kieraneglin/hexagon-art/CAD/cutaway-view.jpg

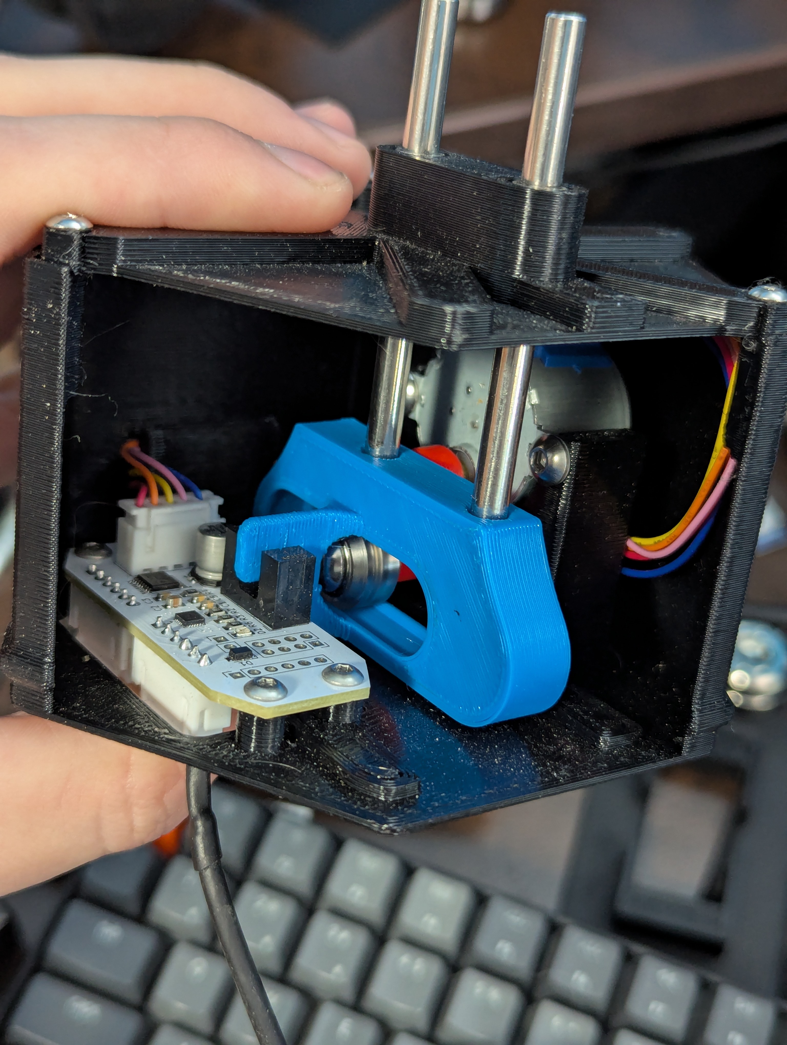
CAD/cutaway-view.jpg
