kieraneglin/hexagon-art/CAD/README.md

# CAD Design for Hexagon Art Piece

## Hardware BOM

### Per-Hexagon Unit

| Part | Quantity | Notes |
| --- | --- | --- |
| M3x10 BHCS | 3 | For attaching lid to body |
| M3x6 BHCS | 2 | For mounting PCB. You can use 4 but there's no need |
| M4x10 BHCS | 2 | For mounting motor |
| M5x16 BHCS | 1 | For mounting POM roller to crank |
| M5x70 Stainless Steel Pins | 2 | [AliExpress](https://www.aliexpress.com/item/1005012213367423.html) |
| M5x7x15 oil-free shaft bushing | 2 | [AliExpress](https://www.aliexpress.com/item/1005004320890614.html) |
| 15.5x8.9 POM wheel | 1 | [AliExpress](https://www.aliexpress.com/item/1005004275676552.html) |
| 28BYJ-48 Stepper Motor | 1 | 12v or 5v - either works. 12v is strongly recommended |
| 6x3 circular magnet | 2 | For attaching the wood piece to the drive pins |
| PCB assembly | 1 | See schematic |
