kieraneglin/hexagon-art/Schematic/hexagon/BOM.csv

Reference | Qty | Value | Footprint | PN
J1,J2,J4,J5,J6,J7,U3 | 7 | ATtiny1616-MN,GPIO Breakout,INPUT BREAKOUT,JST IN,JST OUT,Motor JST,PROGRAMMING BREAKOUT | Connector_JST:JST_XH_B5B-XH-A_1x05_P2.50mm_Vertical,Connector_JST:JST_XH_B6B-XH-A_1x06_P2.50mm_Vertical,Connector_PinHeader_2.54mm:PinHeader_1x02_P2.54mm_Vertical,Connector_PinSocket_2.54mm:PinSocket_1x06_P2.54mm_Vertical,Package_DFN_QFN:VQFN-20-1EP_3x3mm_P0.4mm_EP1.7x1.7mm
D2 | 1 | STATUS LED | LED_SMD:LED_0805_2012Metric_Pad1.15x1.40mm_HandSolder | 5988110107F
C2 | 1 | 10 uF | Capacitor_SMD:C_0805_2012Metric_Pad1.18x1.45mm_HandSolder | C0805C106K8PACTU
C1,C3,C5 | 3 | 100 nF | Capacitor_SMD:C_0805_2012Metric_Pad1.18x1.45mm_HandSolder | CL21B104KACNNNC
PI1 | 1 | LTH-301-07 | OptoDevice:LiteOn_LTH-301-07 | LTH-301-07
D1 | 1 | D_Schottky | Diode_SMD:Nexperia_CFP3_SOD-123W | PMEG2010ER,115
R4 | 1 | 4.7k | Resistor_SMD:R_0805_2012Metric_Pad1.20x1.40mm_HandSolder | RC0805FR-074K7L
R2,R3,R6 | 3 | 220 | Resistor_SMD:R_0805_2012Metric_Pad1.20x1.40mm_HandSolder | RC0805FR-07220RL
U2 | 1 | TPL7407 | Package_SO:TSSOP-16_4.4x5mm_P0.65mm | TPL7407LAQPWRQ1
C4 | 1 | 220 uF | Capacitor_SMD:CP_Elec_6.3x7.7 | UCM1E221MCL1GS
