kieraneglin/hexagon-art/CAD/Hexagon Art.step

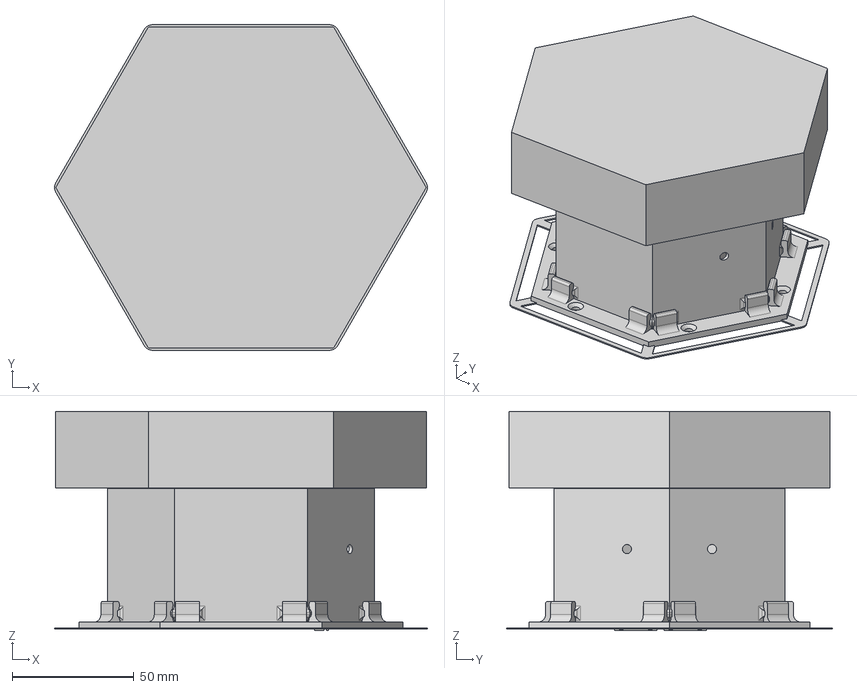
[picture p2: CAD file, 2026-09-25]
CAD/Hexagon Art.step
153.4 x 134.0 x 90.2 mm
Lid
Crank
Yoke
Pin
Motor
Bushing
Slider x 2
Wood Hexagon
Wood Mount
PinSocket_2x04_P2.54mm_Vertical_1
FusionComponent
CP_Elec_63x77
JST_B5B_XH_A
R_0805_2012Metric_1 x 4
PinHeader_1x02_P254mm_Vertical
C_0805_2012Metric_1 x 4
LED_0805_2012Metric_1
PinSocket_1x06_P2.54mm_Vertical_1
60816e3e-9268-11ed-8af4-a0cec80452fd_part
6081710e-9268-11ed-8af4-a0cec80452fd_part
6081737a-9268-11ed-8af4-a0cec80452fd_part
TSSOP-16_4.4x5mm_P0.65mm_1
JST_B6B_XH_A x 2
hexagon_PCB
Container Mount
