kieraneglin/hexagon-art/(list of files, cad)

Other CAD files:
CAD/Hexagon Art.f3d
