kieraneglin/hexagon-art/Schematic/distributor/distributor.kicad_pcb

## KiCad design Schematic/distributor/distributor.kicad_pcb (2026-09-25)

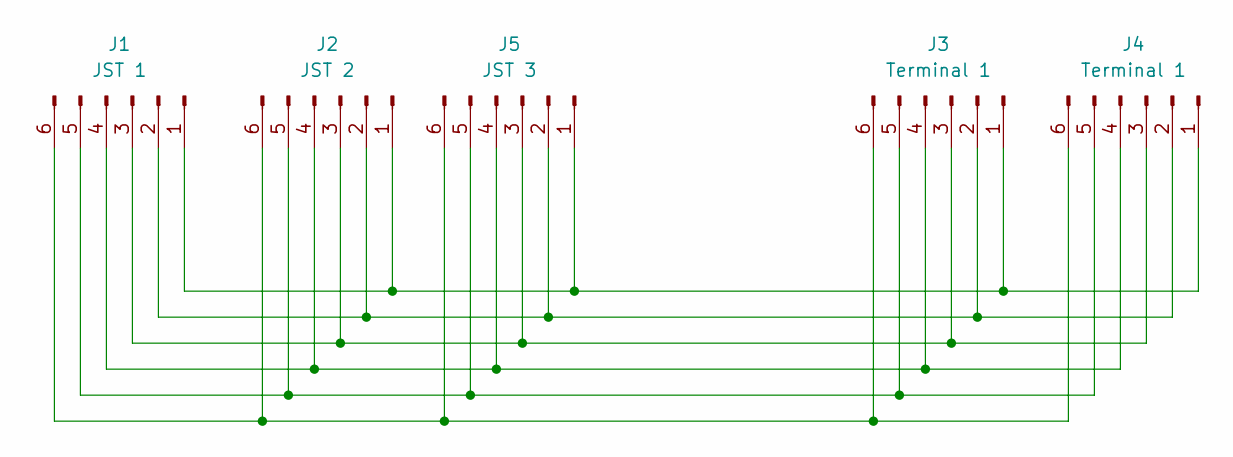
[picture p3: schematic distributor.kicad_sch]

Parts:
J1: JST 1; JST_XH_S6B-XH-A_1x06_P2.50mm_Horizontal
J2: JST 2; JST_XH_S6B-XH-A_1x06_P2.50mm_Horizontal
J3, J4: Terminal 1; QT06
J5: JST 3; JST_XH_S6B-XH-A_1x06_P2.50mm_Horizontal

Connections:
unnamed: J1.1, J2.1, J3.1, J4.1, J5.1
unnamed: J1.2, J2.2, J3.2, J4.2, J5.2
unnamed: J1.3, J2.3, J3.3, J4.3, J5.3
unnamed: J1.4, J2.4, J3.4, J4.4, J5.4
unnamed: J1.5, J2.5, J3.5, J4.5, J5.5
unnamed: J1.6, J2.6, J3.6, J4.6, J5.6

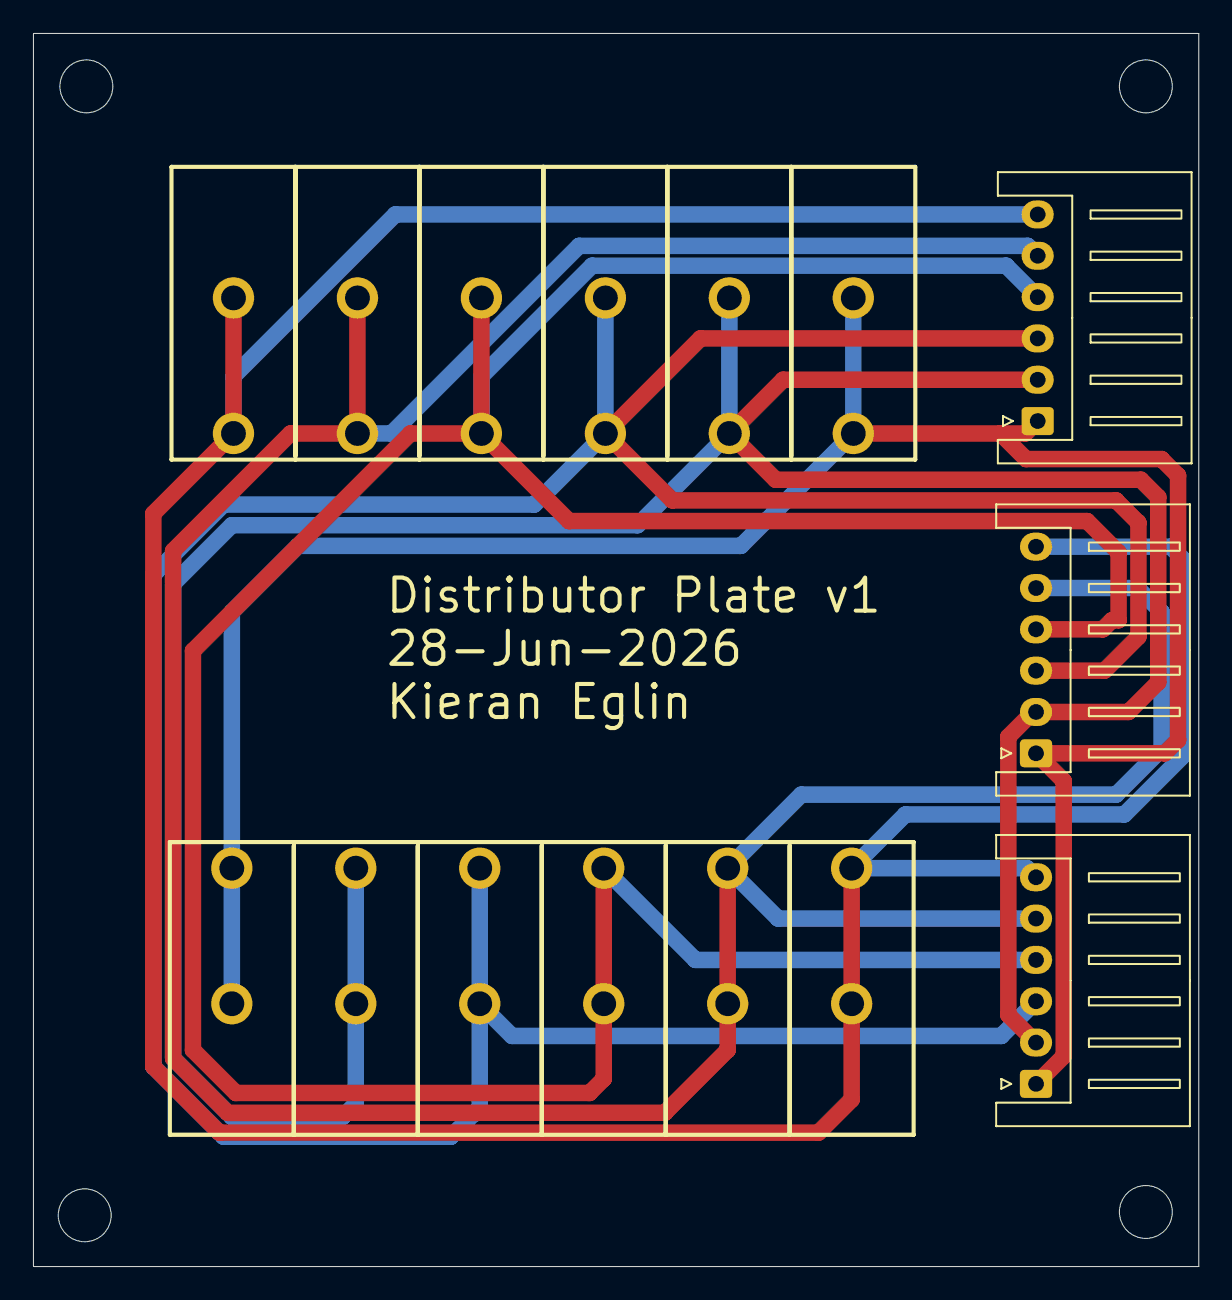
[picture p4: board distributor.kicad_pcb from above]

Board: 2 copper layers, 70.5 x 74.6 mm, 5 parts (0 on the bottom side), 6 nets.
