kieraneglin/hexagon-art/Schematic/hexagon/hexagon.kicad_pcb

## KiCad design Schematic/hexagon/hexagon.kicad_pcb (2026-09-25)

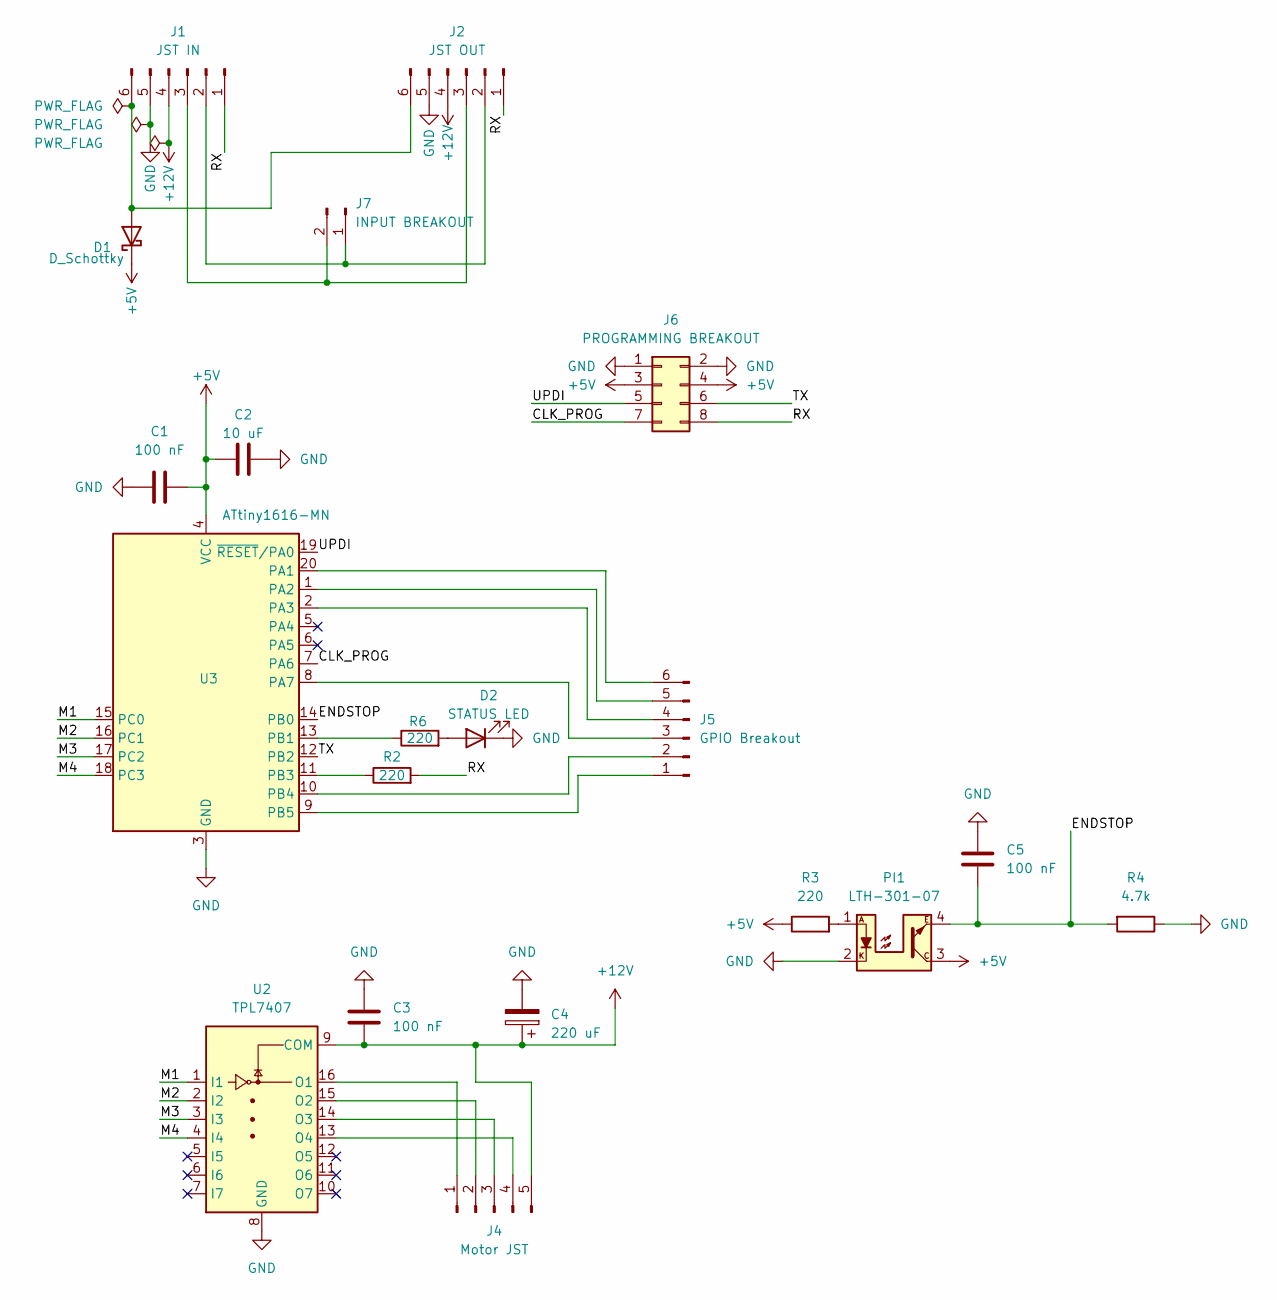
[picture p5: schematic hexagon.kicad_sch]

Parts:
C1, C3, C5: 100 nF; C_0805_2012Metric_Pad1.18x1.45mm_HandSolder
C2: 10 uF; C_0805_2012Metric_Pad1.18x1.45mm_HandSolder
C4: 220 uF; CP_Elec_6.3x7.7
D1: D_Schottky; Nexperia_CFP3_SOD-123W
D2: STATUS LED; LED_0805_2012Metric_Pad1.15x1.40mm_HandSolder
J1: JST IN; JST_XH_B6B-XH-A_1x06_P2.50mm_Vertical
J2: JST OUT; JST_XH_B6B-XH-A_1x06_P2.50mm_Vertical
J4: Motor JST; JST_XH_B5B-XH-A_1x05_P2.50mm_Vertical
J5: GPIO Breakout; PinSocket_1x06_P2.54mm_Vertical
J6: PROGRAMMING BREAKOUT
J7: INPUT BREAKOUT; PinHeader_1x02_P2.54mm_Vertical
PI1: LTH-301-07; LiteOn_LTH-301-07
R2, R3, R6: 220; R_0805_2012Metric_Pad1.20x1.40mm_HandSolder
R4: 4.7k; R_0805_2012Metric_Pad1.20x1.40mm_HandSolder
U2: TPL7407; TSSOP-16_4.4x5mm_P0.65mm
U3: ATtiny1616-MN; VQFN-20-1EP_3x3mm_P0.4mm_EP1.7x1.7mm

Connections:
+5V: C1.2, C2.2, D1.1 (K), J6.3, J6.4, PI1.3, R3.1, U3.4 (VCC)
+12V: C3.2, C4.1, J1.4, J2.4, J4.5, U2.9 (COM)
/CLK_PROG: J6.7, U3.7 (PA6)
/ENDSTOP: C5.2, PI1.4, R4.2, U3.14 (PB0)
/M1: U2.1 (I1), U3.15 (PC0)
/M2: U2.2 (I2), U3.16 (PC1)
/M3: U2.3 (I3), U3.17 (PC2)
/M4: U2.4 (I4), U3.18 (PC3)
/RX: J1.1, J2.1, J6.8, R2.2
/TX: J6.6, U3.12 (PB2)
/UPDI: J6.5, U3.19 (~RESET/PA0)
GND: C1.1, C2.1, C3.1, C4.2, C5.1, D2.1 (K), J1.5, J2.5, J6.1, J6.2, PI1.2, R4.1, U2.8 (GND), U3.3 (GND), U3.21 (GND)
unnamed: D1.2 (A), J1.6, J2.6
unnamed: D2.2 (A), R6.2
unnamed: J1.2, J2.2, J7.1
unnamed: J1.3, J2.3, J7.2
unnamed: J4.1, U2.16 (O1)
unnamed: J4.2, U2.15 (O2)
unnamed: J4.3, U2.14 (O3)
unnamed: J4.4, U2.13 (O4)
unnamed: J5.1, U3.9 (PB5)
unnamed: J5.2, U3.10 (PB4)
unnamed: J5.3, U3.8 (PA7)
unnamed: J5.4, U3.2 (PA3)
unnamed: J5.5, U3.1 (PA2)
unnamed: J5.6, U3.20 (PA1)
unnamed: PI1.1, R3.2
unnamed: R6.1, U3.13 (PB1)
unnamed: R2.1, U3.11 (PB3)

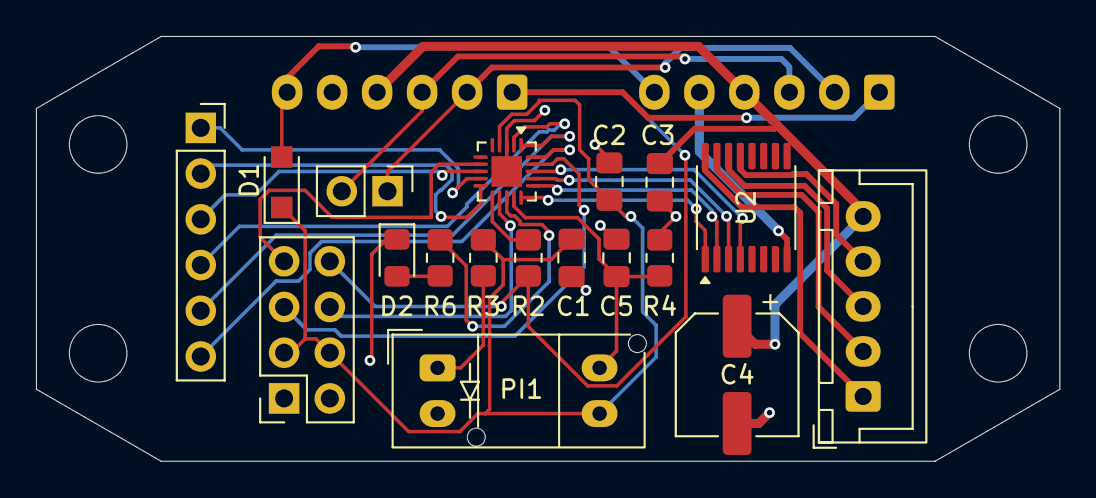
[picture p6: board hexagon.kicad_pcb from above]

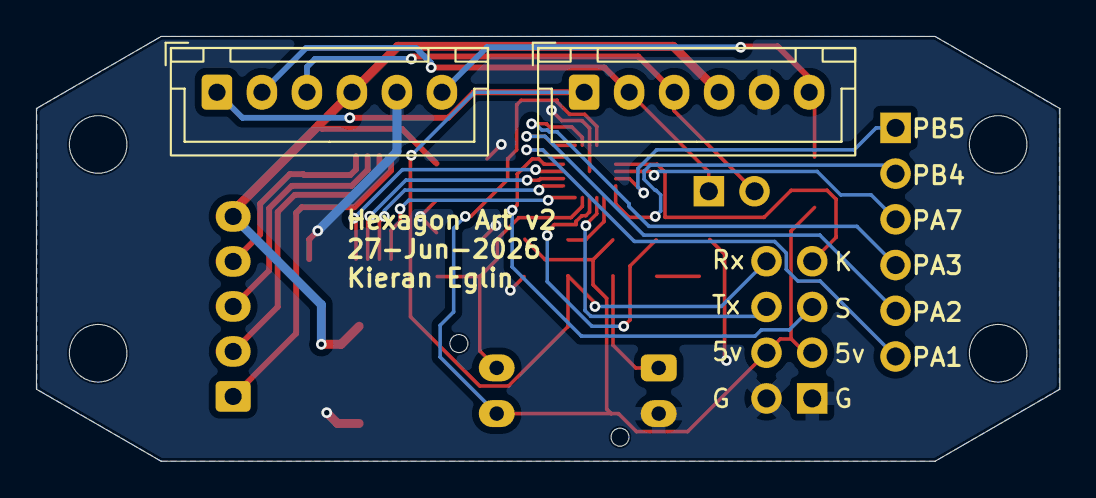
[picture p7: board hexagon.kicad_pcb from below]

Board: 2 copper layers, 56.9 x 23.6 mm, 20 parts (2 on the bottom side), 29 nets.
