kieraneglin/hexagon-art/(commit log)

2026-09-25 Moved calibration sketch
2026-09-25 Added a BOM
    [BOM.csv]
2026-09-25 Added CAD README
